elcocogo/adaptive-michelangelo-finger/3d_models/Finger.step

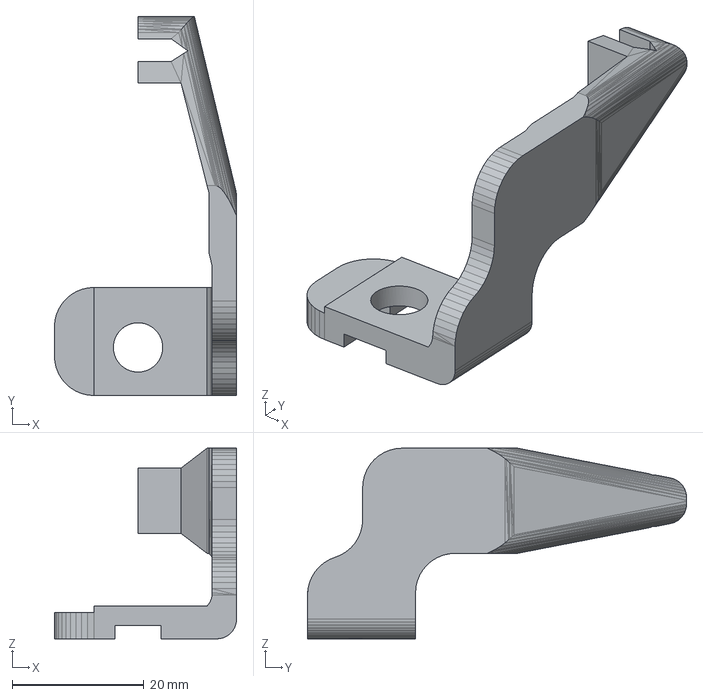
[picture p5: CAD file, 2026-09-01]
3d_models/Finger.step
27.7 x 57.6 x 29.0 mm
