elcocogo/adaptive-michelangelo-finger/3d_models/Base.step

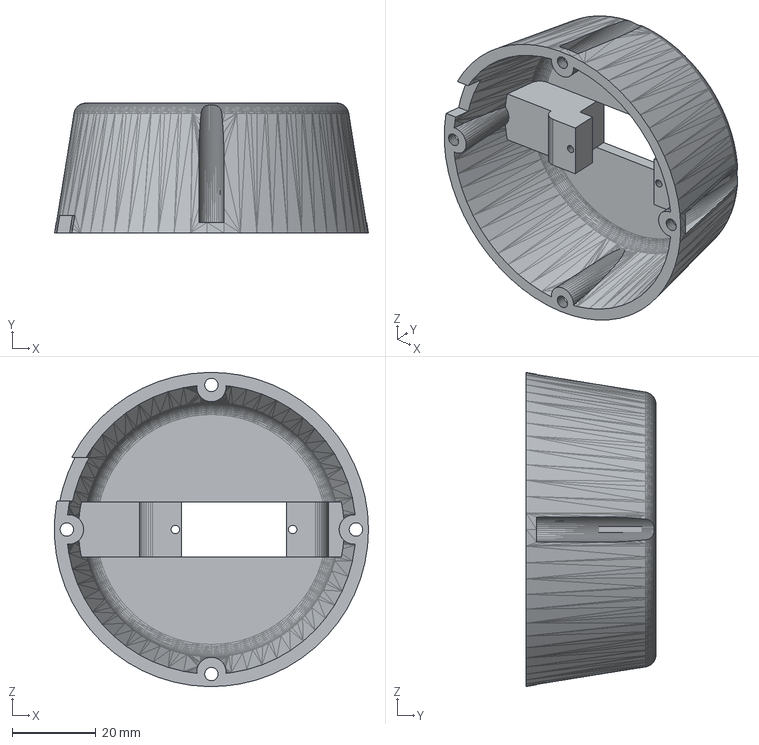
[picture p6: CAD file, 2026-09-01]
3d_models/Base.step
74.9 x 31.0 x 75.0 mm
