elcocogo/adaptive-michelangelo-finger/3d_models/GripperArm.step

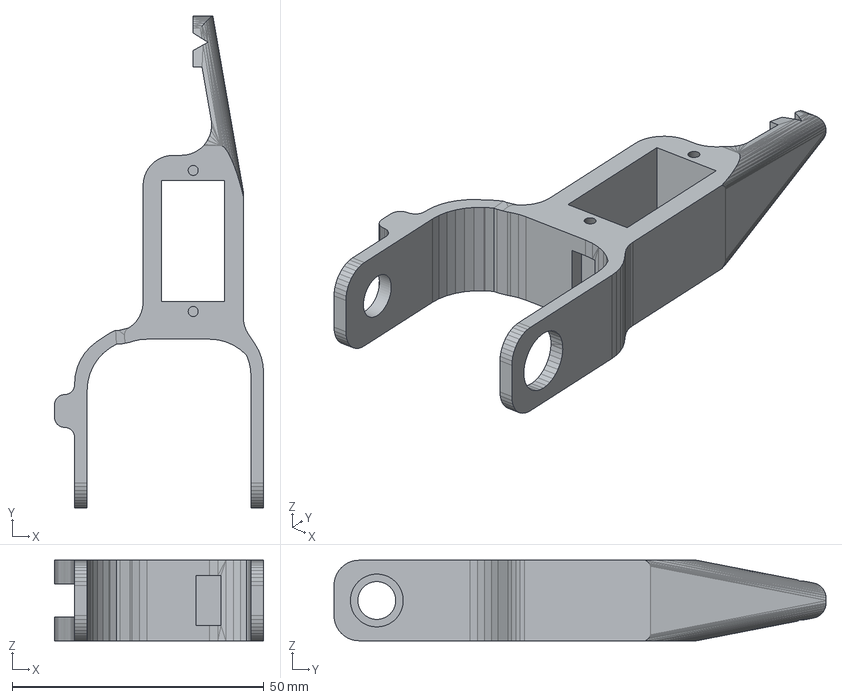
[picture p7: CAD file, 2026-09-01]
3d_models/GripperArm.step
41.5 x 97.6 x 16.0 mm
