elcocogo/adaptive-michelangelo-finger/3d_models/BaseSpin.step

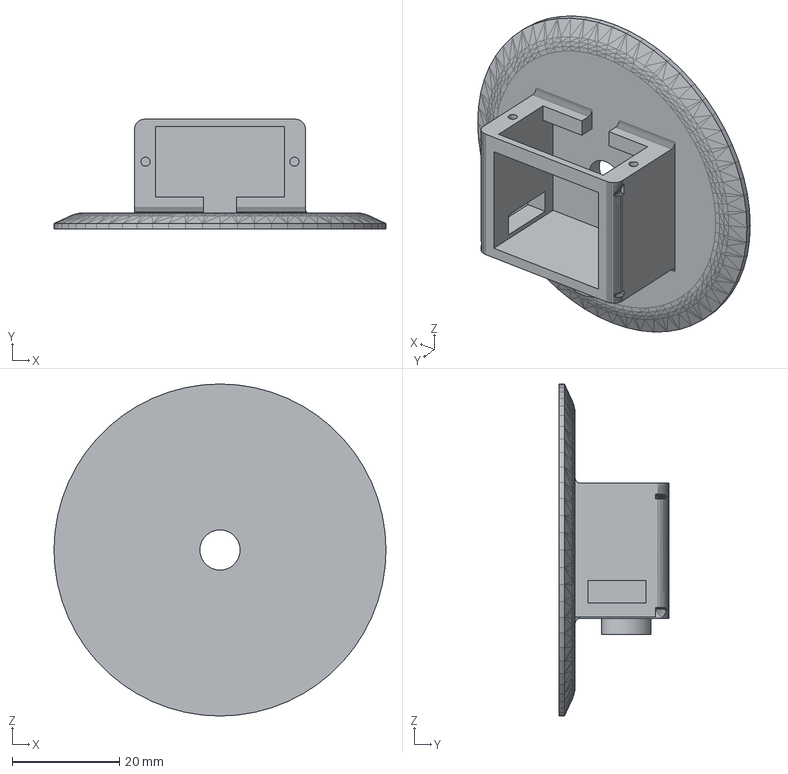
[picture p8: CAD file, 2026-09-01]
3d_models/BaseSpin.step
62.0 x 20.5 x 62.0 mm
