elcocogo/adaptive-michelangelo-finger/3d_models/MidArm.step

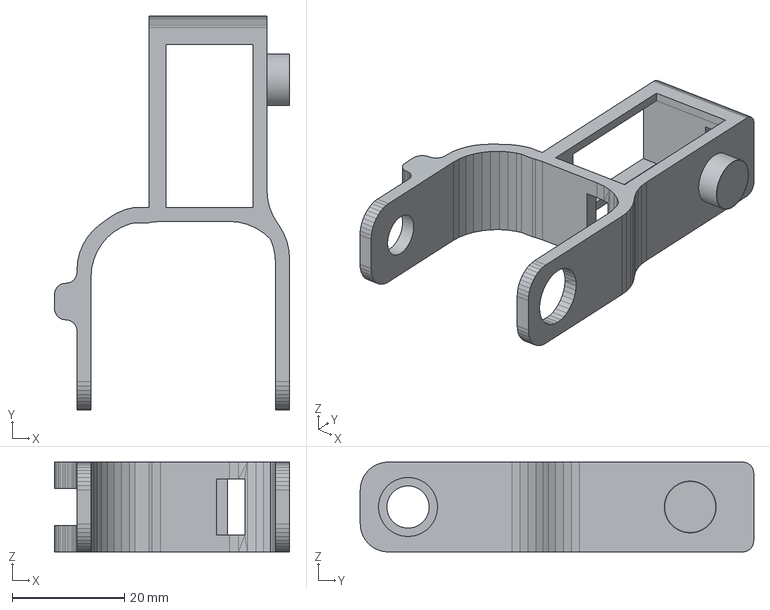
[picture p9: CAD file, 2026-09-01]
3d_models/MidArm.step
41.8 x 70.0 x 16.0 mm
