elcocogo/adaptive-michelangelo-finger/3d_models/BaseArm.step

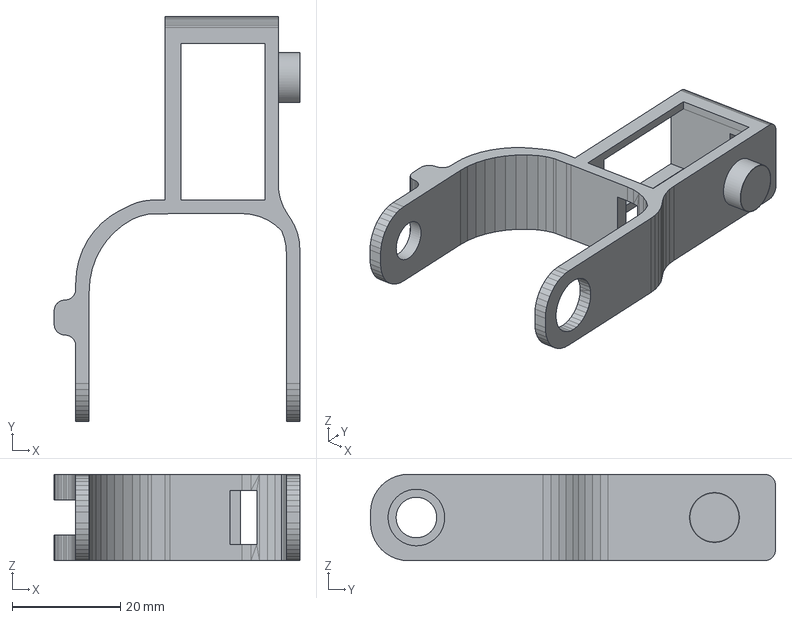
[picture p10: CAD file, 2026-09-01]
3d_models/BaseArm.step
45.5 x 75.0 x 16.0 mm
