elcocogo/adaptive-michelangelo-finger/(list of files, cad)

Other CAD files:
3d_models/Base.FCStd
3d_models/BaseArm.FCStd
3d_models/BaseSpin.FCStd
3d_models/Finger.FCStd
3d_models/GripperArm.FCStd
3d_models/MidArm.FCStd
