elcocogo/adaptive-michelangelo-finger/(commit log)

2026-08-27 Initial commit: servo calibration, manual control, and demo choreography
    Tools to bring up the PCA9685-driven 5-DOF arm: calibrate_servo.py finds
    each servo's pulse bounds by hand, move_servo.py drives a calibrated
    servo to a given angle with a speed-limited ramp, and arm_show.py chains
    synchronized multi-joint poses into a demo sequence.
2026-08-28 Add camera positioning tools, fix I2C bus after hardware failure
    camera_calibration/: live_view.py serves a live MJPEG feed from both
    cameras (side-by-side or stacked) with terminal control of the base and
    shoulder joints, for physically positioning the stereo pair;
    generate_targets.py produces a print-ready ChArUco board + standalone
    ArUco markers for the upcoming stereo calibration.
    servo_calibration/pca9685_driver.py: rpi502's hardware I2C1 (GPIO2/3)
    failed permanently (kernel "lost arbitration" errors, reproduced across
    3 PCA9685 boards, persists across reboots). Switched to a software I2C
    bus on GPIO23/24 (adafruit-extended-bus + dtoverlay=i2c-gpio,bus=3),
    documented in CLAUDE.md.
    [generate_targets.py, live_view.py, pca9685_driver.py]
2026-08-30 Add stereo calibration pipeline, translate all terminal output to English
    camera_calibration/: charuco_board.py (shared board config, using the
    measured 25.6mm square size), capture_stereo_images.py (live-preview
    capture tool, now with --layout), calibrate_stereo.py (intrinsics +
    extrinsics via cv2.calibrateCamera/stereoCalibrate, heavily commented),
    stereo_data.py (result persistence). README documents each field of
    stereo_calibration.json and what it feeds into next.
    Every print/input/argparse string across servo_calibration/ and
    camera_calibration/ is now in English (source comments already were),
    so the project stays usable by non-French speakers — only CLAUDE.md
    stays French. Both pa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
2026-08-30 Add camera-to-arm frame calibration
    triangulation.py: generic 2D-pixel-pair -> 3D-point triangulation from
    the stereo calibration, validated against the 20 real ChArUco capture
    pairs (expected 25.6mm between adjacent corners, got -0.028mm mean
    error, 0.125mm stddev).
    aruco_markers.py: standalone ArUco tag detection (as opposed to the
    ChArUco board).
    calibrate_camera_to_arm.py + arm_frame_data.py: computes the rigid
    transform from camera 0's frame to the arm's own frame (origin below
    base_joint's rotation axis, X at base_joint=0, Z up) from two
    floor-mounted ArUco tags — their measured positions plus their
    independently-detected floor normals fully constrain the transform, no
    need to alig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
    [arm_frame_data.py, aruco_markers.py, calibrate_camera_to_arm.py, triangulation.py]
2026-08-30 Add forward/inverse kinematics for the 5-DOF arm
    Channels 1-3 share parallel axes, so the chain reduces to a planar
    3-link arm plus a base rotation. Inverse kinematics resolves the
    resulting redundancy (4 joints for a 3D target) by locking midarm_joint
    to the wrist, turning it into a standard 2-link planar solve (law of
    cosines), with elbow_up choosing between the two remaining solutions.
    Validated with hand-computed cases and a 2000-sample randomized
    FK -> IK -> FK round-trip (max position error 0.000000mm). Uses the
    arm's real measured dimensions (45/54/50/40mm), not the early ~5cm
    estimate.
2026-08-30 Add the visual tracking loop, home position, and joint-limit-aware IK
    tracking/follow_target.py: the full loop — detect an ArUco tag in both
    cameras, triangulate, transform to the arm frame, back off by a
    configurable standoff (apply_standoff), solve inverse kinematics, and
    drive the arm there continuously with a live MJPEG preview.
    servo_calibration/go_home.py: returns the arm to 0 deg on all channels;
    follow_target.py calls it on quit instead of leaving the arm wherever
    it last pointed.
    kinematics/arm_kinematics.py: inverse_kinematics now takes an explicit
    theta3_deg instead of always locking it to 0, and a new
    inverse_kinematics_search tries wrist angles until one keeps every
    joint wi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
2026-08-30 Add gripper-pointing mode: aim gripper_arm at the target, not just reach near it
    kinematics/arm_kinematics.py: inverse_kinematics_pointing pins the wrist
    angle so gripper_arm stays parallel to the line from the wrist through
    the target, instead of treating theta3 as a free parameter. Closed-form,
    no search: since gripper_arm's length is fixed, placing the wrist
    exactly (gripper_arm_mm + standoff_mm) from the target along the
    shoulder-target line (apply_standoff, applied to the wrist instead of
    the fingertip) fully determines the geometry. Falls back from
    elbow_up=True to False if needed to stay within given joint bounds.
    Validated over 500 randomized reachable targets: 0.000000mm error on
    th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
    [follow_target.py]
2026-08-30 Add --record to save the annotated tracking view to video
    Runs its own capture+annotate loop (recording_loop) rather than
    piggybacking on the MJPEG preview, since the preview only renders
    frames while a browser is actually connected to /stream. Saves to
    tracking/recordings/ (gitignored, not source) as timestamped .mp4
    files, same side-by-side/stacked annotated view shown live.
2026-08-30 Add project README: hardware, software pipeline, results, run order
    Documents the build in the order it happened: servo bring-up, the I2C1
    hardware failure and its workaround, stereo camera calibration,
    camera-to-arm frame calibration, kinematics (including the joint-limit
    and gripper-pointing solvers), and the tracking loop. Mechanical design
    and physical construction/calibration are documented separately.
2026-08-30 Ignore notes/ for personal working documents
    Video scripts, presentation notes, etc. — not project source, not
    meant to be published in the repo.
2026-08-31 Update README description: printed fresco fingers, not a bare fingertip
    The project now uses two 3D-printed replicas of the Creation of Adam's
    fingers — one on the arm, one on a hand-held wand — instead of pointing
    at a bare finger directly.
2026-09-01 Add 3D models, project photos, and a full documentation pass
    3d_models/: FreeCAD sources + STEP exports for the arm's printed parts
    (base "grippy-bot" design by ROBOTEURS, CC BY-NC, reworked for MG90S
    servos — see LICENSE.md), and images/ with the project banner/photos
    and a wiring diagram.
    README.md: banner + photos, intro context (built in 4 days for a
    European Robotics House application, first non-simulation robotics
    project), link to the demo video, pointer to 3d_models/.
    Documentation audit across every README and CLAUDE.md: fixed several
    claims that had drifted from the actual current state — i2cdetect bus
    number (1 -> 3, post I2C1 failure), spin_joint's real calibrated range
    (-3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
    [Base.FCStd, Base.step, BaseArm.FCStd, BaseArm.step, BaseSpin.FCStd, BaseSpin.step, Finger.FCStd, Finger.step]
2026-09-01 Update README description: printed fresco fingers, not a bare fingertip
